adafruit/Adafruit-RP2350-HSTX-to-DVI-Adapter-PCB/Adafruit RP2350 HSTX to DVI Adapter.brd

## EAGLE design Adafruit RP2350 HSTX to DVI Adapter.brd (2024-10-02)

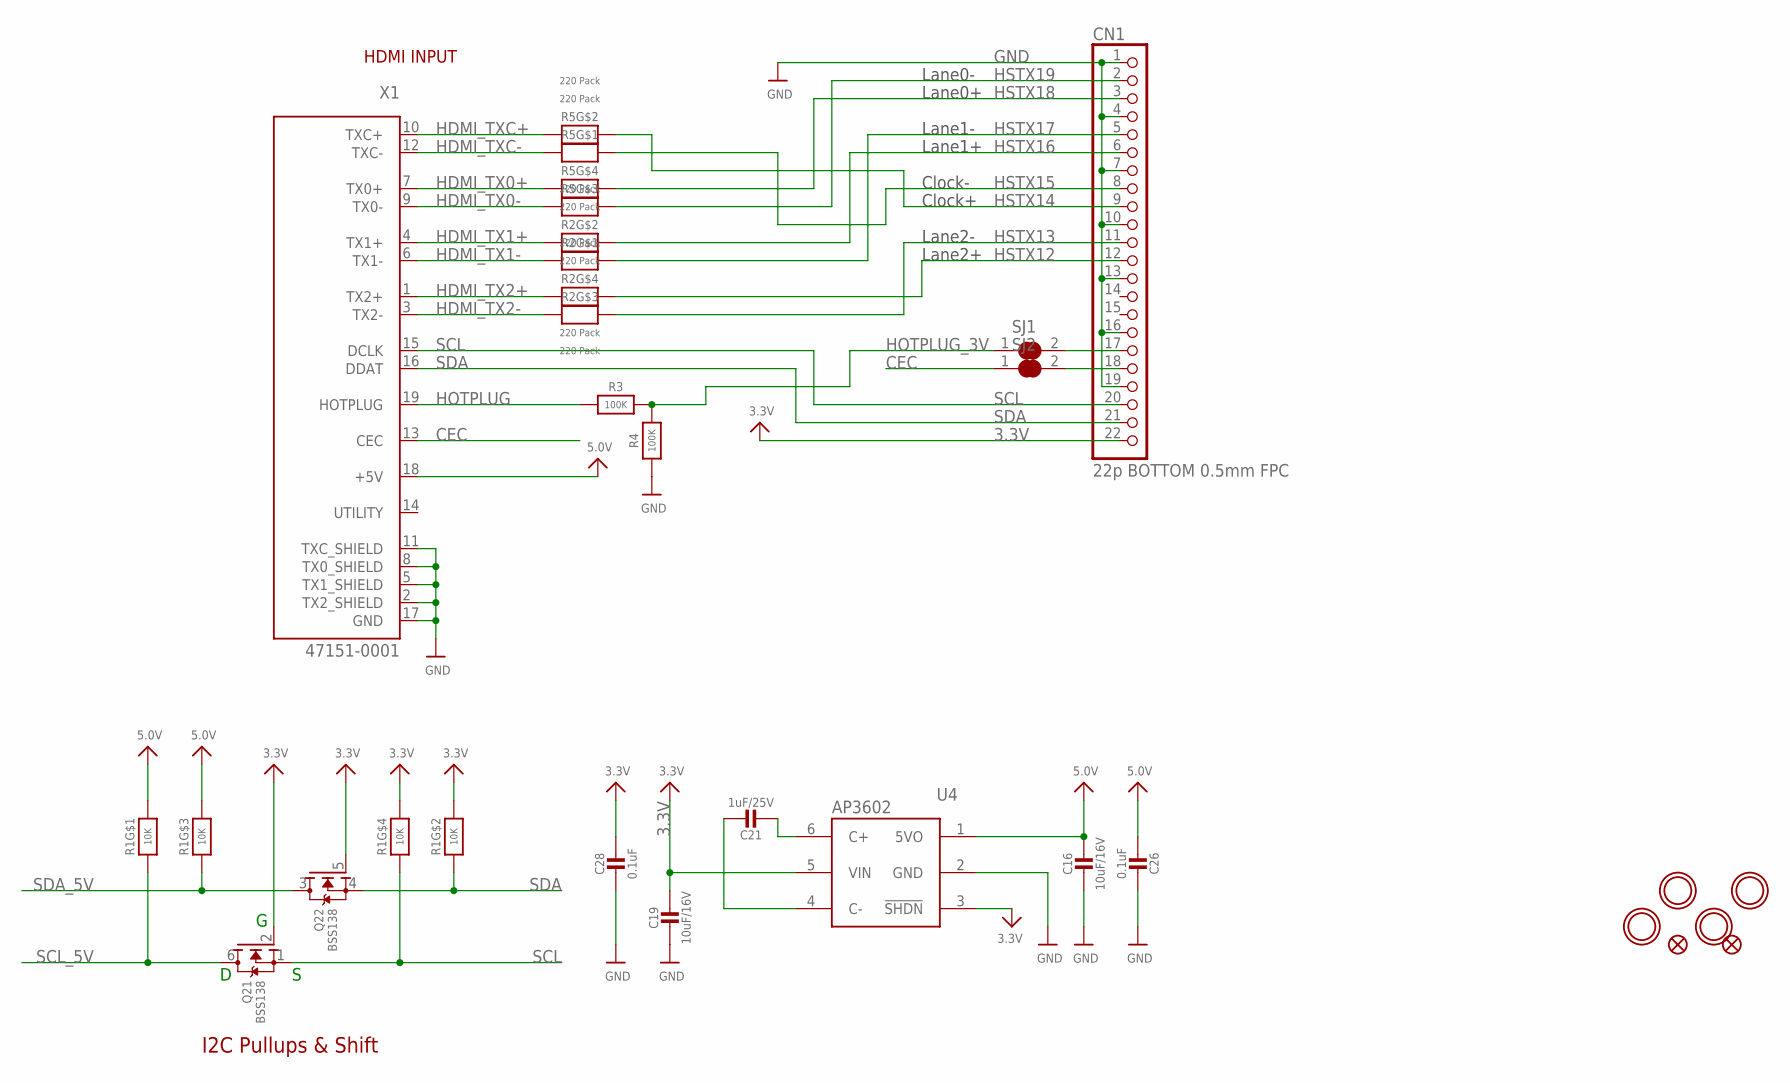
[picture p2: schematic Adafruit RP2350 HSTX to DVI Adapter.sch]

Parts:
C16, C19: 10uF/16V; 0805-NO
C21: 1uF/25V; 0603-NO
C26, C28: 0.1uF; 0603-NO
CN1: 22p BOTTOM 0.5mm FPC; FPC_22PIN
FID1, FID2: FIDUCIAL_1MM
Q2: BSS138; SOT363
R1: 10K; RESPACK_4X0603
R2, R5: 220 Pack; RESPACK_4X0603
R3, R4: 100K; 0603-NO
SJ1, SJ2: SOLDERJUMPER_CLOSED; SOLDERJUMPER_CLOSEDWIRE
U4: AP3602; SOT23-6
U$2, U$3, U$5, U$7: MOUNTINGHOLE2.5; MOUNTINGHOLE_2.5_PLATED
X1: 47151-0001; HDMI_MOLEX_47151-0001

Connections:
3.3V: C19.1, C28.1, CN1.22, Q2.2 (G), Q2.5 (G), R1.5 (2), R1.7 (2), U4.3 (!SHDN), U4.5 (VIN)
5.0V: C16.1, C26.2, R1.6 (2), R1.8 (2), U4.1 (5VO), X1.18 (+5V)
CEC: SJ2.1, X1.13 (CEC)
GND: C16.2, C19.2, C26.1, C28.2, CN1.1, CN1.4, CN1.7, CN1.10, CN1.13, CN1.16, CN1.19, R4.1, U4.2 (GND), X1.2 (TX2_SHIELD), X1.5 (TX1_SHIELD), X1.8 (TX0_SHIELD), X1.11 (TXC_SHIELD), X1.17 (GND), X1.P$1 (GND), X1.P$2 (GND), X1.P$3 (GND), X1.P$4 (GND)
HDMI_TX0+: R5.4 (1), X1.7 (TX0+)
HDMI_TX0-: R5.3 (1), X1.9 (TX0-)
HDMI_TX1+: R2.2 (1), X1.4 (TX1+)
HDMI_TX1-: R2.1, X1.6 (TX1-)
HDMI_TX2+: R2.4 (1), X1.1 (TX2+)
HDMI_TX2-: R2.3 (1), X1.3 (TX2-)
HDMI_TXC+: R5.2 (1), X1.10 (TXC+)
HDMI_TXC-: R5.1, X1.12 (TXC-)
HOTPLUG: R3.1, X1.19 (HOTPLUG)
HOTPLUG_3V: R3.2, R4.2, SJ1.1
HSTX12: CN1.12, R2.5 (2)
HSTX13: CN1.11, R2.6 (2)
HSTX14: CN1.9, R5.7 (2)
HSTX15: CN1.8, R5.8 (2)
HSTX16: CN1.6, R2.7 (2)
HSTX17: CN1.5, R2.8 (2)
HSTX18: CN1.3, R5.5 (2)
HSTX19: CN1.2, R5.6 (2)
unnamed: CN1.17, SJ1.2
unnamed: CN1.18, SJ2.2
unnamed: C21.1, U4.4 (C-)
unnamed: C21.2, U4.6 (C+)
SCL: CN1.20, Q2.1 (S), R1.4 (1), X1.15 (DCLK)
SCL_5V: Q2.6 (D), R1.1
SDA: CN1.21, Q2.4 (S), R1.2 (1), X1.16 (DDAT)
SDA_5V: Q2.3 (D), R1.3 (1)

Notes on the sheet:
HDMI INPUT
I2C Pullups & Shift
Lane0-
Lane0+
Lane1-
Lane1+
Clock-
Clock+
Lane2-
Lane2+

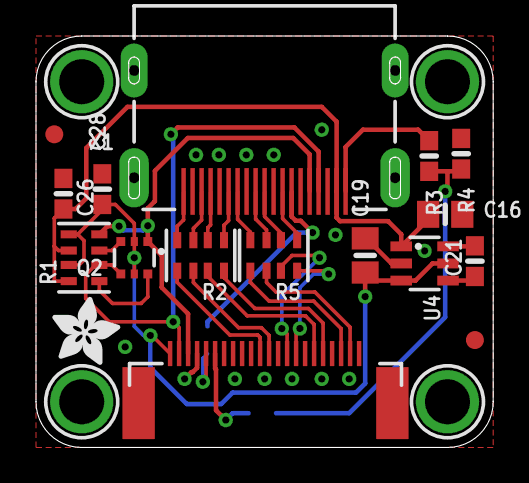
[picture p3: board Adafruit RP2350 HSTX to DVI Adapter.brd from above]

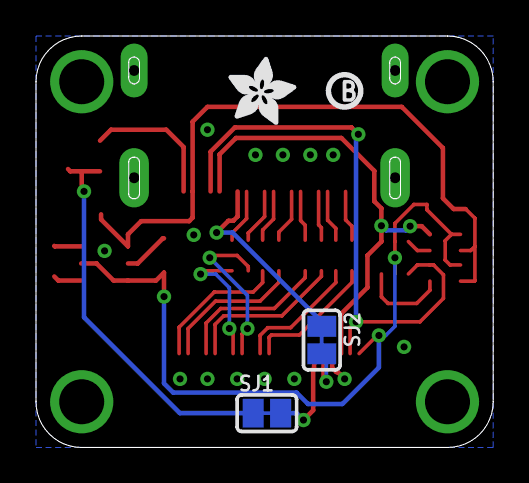
[picture p4: board Adafruit RP2350 HSTX to DVI Adapter.brd from below]

Board: 2 copper layers, 25.4 x 22.9 mm, 30 parts (7 on the bottom side), 30 nets.

Other parts of the board:
PLABEL0: PLABEL0
PLABEL1: PLABEL1
PLABEL2: PLABEL2
PLABEL3: PLABEL3
PLABEL4: PLABEL4
U$4, U$21: ADAFRUIT_3.5MM
U$6: PCBFEAT-REV-040
